tommasogualtierotti/14keypad/README.md

# 14keypad
14 keys programmable Macropad, based on RP2040 MCU from Raspberry Pi, running [KMK](https://github.com/KMKfw/kmk_firmware) firmware

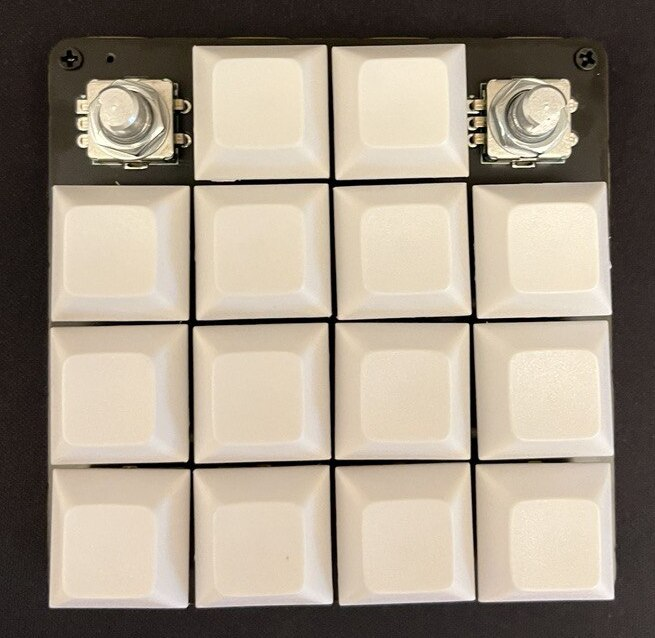
[picture p1: v1/assembled.jpg]
