tommasogualtierotti/14keypad/v1/back.png

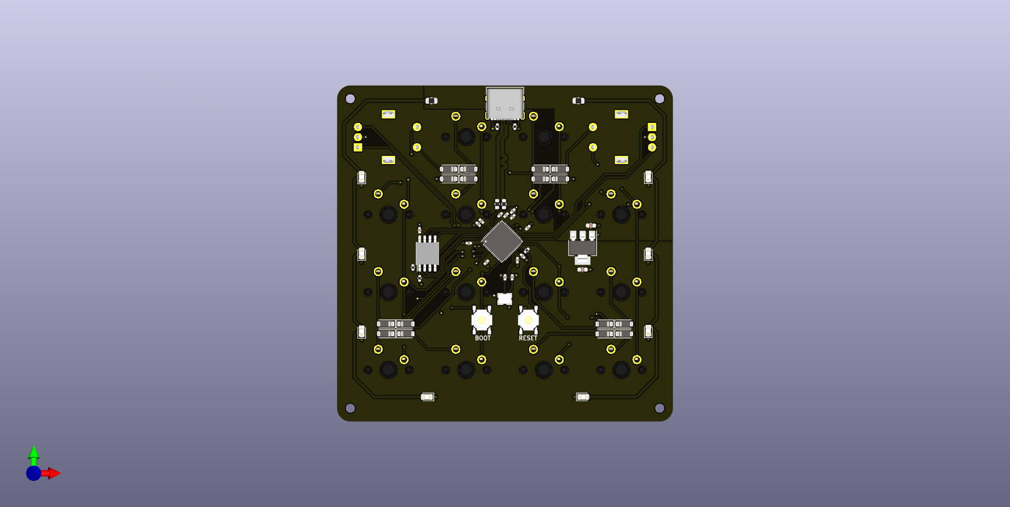
v1/back.png
