tommasogualtierotti/14keypad/v1/14keypad.kicad_pcb

## KiCad design v1/14keypad.kicad_pcb (2023-10-14)

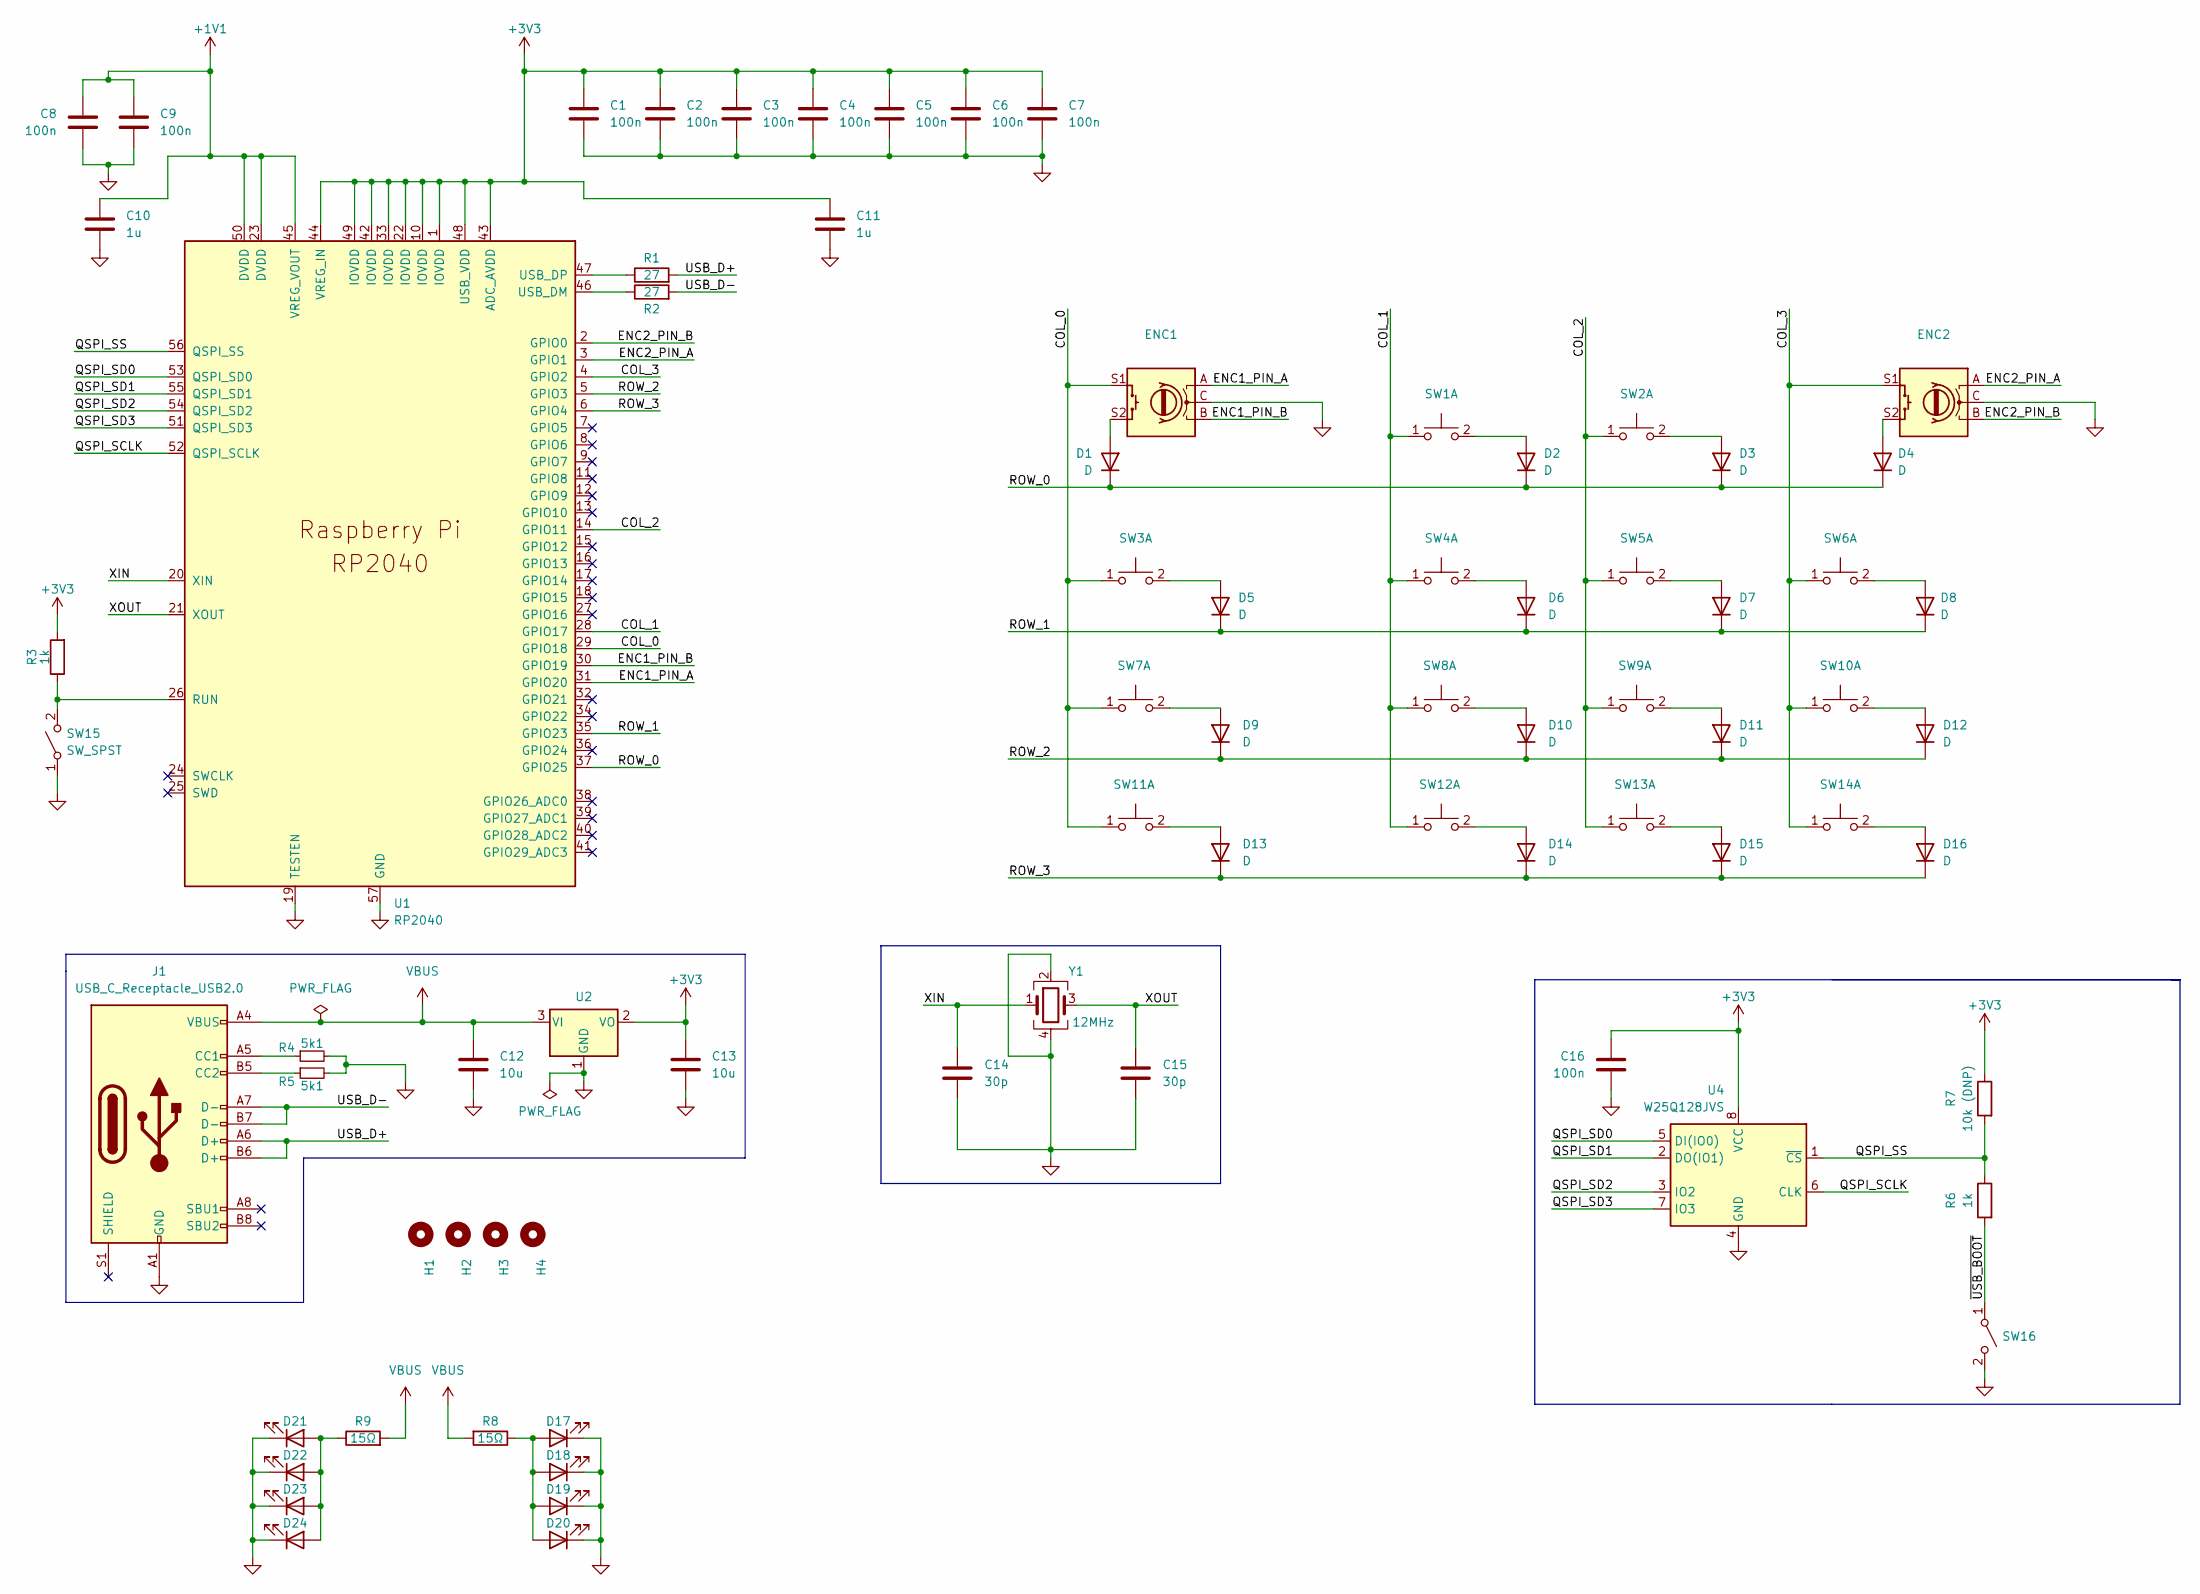
[picture p3: schematic 14keypad.kicad_sch]

Parts:
C1, C2, C3, C4, C5, C6, C7, C8, C9, C16: 100n; C_0402_1005Metric
C10, C11: 1u; C_0402_1005Metric
C12, C13: 10u; C_0603_1608Metric
C14, C15: 30p; C_0402_1005Metric
D1, D2, D3, D4, D5, D6, D7, D8, D9, D10, D11, D12, D13, D14, D15, D16: D; D_SOD-123
D17, D18, D19, D20, D21, D22, D23, D24: LED; D_0805_2012Metric
ENC1, ENC2: Encoder_Switch; RotaryEncoder_Alps_EC11E-Switch_Vertical_H20mm
H1, H2, H3, H4: MountingHole; MountingHole_2.2mm_M2
J1: USB_C_Receptacle_USB2.0; USB_C_Receptacle_XKB_U262-16XN-4BVC11
R1, R2: 27; R_0603_1608Metric
R3, R6: 1k; R_0402_1005Metric
R4, R5: 5k1; R_0402_1005Metric
R7: 10k (DNP); R_0402_1005Metric
R8: 15Ω; R_0805_2012Metric
R9: 15Ω; R_0805_2012Metric; JLCPCB_PART_NUMBER C17480
SW1, SW2, SW3, SW4, SW5, SW6, SW7, SW8, SW9, SW10, SW11, SW12, SW13, SW14: KEY_MX; SW_Cherry_MX_1.00u_PCB_UPDATED_FOOTPRINT_RIGHT_PIN_ASSIGNME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
SW15, SW16: SW_SPST; SW_Push_1P1T_XKB_TS-1187A
U1: RP2040; RP2040-QFN-56; JLCPCB_PART_NUMBER C2040
U2: NCP1117-3.3_SOT223; SOT-223-3_TabPin2
U4: W25Q128JVS; SOIC-8_5.23x5.23mm_P1.27mm
Y1: 12MHz; Crystal_SMD_3225-4Pin_3.2x2.5mm

Connections:
+1V1: C8.2, C9.1, C10.1, U1.23 (DVDD), U1.45 (VREG_VOUT), U1.50 (DVDD)
+3V3: C1.1, C2.1, C3.1, C4.1, C5.1, C6.1, C7.1, C11.1, C13.1, C16.1, R3.2, R7.1, U1.1 (IOVDD), U1.10 (IOVDD), U1.22 (IOVDD), U1.33 (IOVDD), U1.42 (IOVDD), U1.43 (ADC_AVDD), U1.44 (VREG_IN), U1.48 (USB_VDD), U1.49 (IOVDD), U2.2 (VO), U4.8 (VCC)
/COL_0: ENC1.S1, SW3.1, SW7.1, SW11.1, U1.29 (GPIO18)
/COL_1: SW1.1, SW4.1, SW8.1, SW12.1, U1.28 (GPIO17)
/COL_2: SW2.1, SW5.1, SW9.1, SW13.1, U1.14 (GPIO11)
/COL_3: ENC2.S1, SW6.1, SW10.1, SW14.1, U1.4 (GPIO2)
/ENC1_PIN_A: ENC1.A, U1.31 (GPIO20)
/ENC1_PIN_B: ENC1.B, U1.30 (GPIO19)
/ENC2_PIN_A: ENC2.A, U1.3 (GPIO1)
/ENC2_PIN_B: ENC2.B, U1.2 (GPIO0)
/QSPI_SCLK: U1.52 (QSPI_SCLK), U4.6 (CLK)
/QSPI_SD0: U1.53 (QSPI_SD0), U4.5 (DI(IO0))
/QSPI_SD1: U1.55 (QSPI_SD1), U4.2 (DO(IO1))
/QSPI_SD2: U1.54 (QSPI_SD2), U4.3 (IO2)
/QSPI_SD3: U1.51 (QSPI_SD3), U4.7 (IO3)
/QSPI_SS: R6.1, R7.2, U1.56 (QSPI_SS), U4.1 (~CS)
/ROW_0: D1.1 (K), D2.1 (K), D3.1 (K), D4.1 (K), U1.37 (GPIO25)
/ROW_1: D5.1 (K), D6.1 (K), D7.1 (K), D8.1 (K), U1.35 (GPIO23)
/ROW_2: D9.1 (K), D10.1 (K), D11.1 (K), D12.1 (K), U1.5 (GPIO3)
/ROW_3: D13.1 (K), D14.1 (K), D15.1 (K), D16.1 (K), U1.6 (GPIO4)
/USB_D+: J1.A6 (D+), J1.B6 (D+), R1.2
/USB_D-: J1.A7 (D-), J1.B7 (D-), R2.2
/XIN: C14.1, U1.20 (XIN), Y1.1
/XOUT: C15.1, U1.21 (XOUT), Y1.3
/~USB_BOOT: R6.2, SW16.1 (A)
GND: C1.2, C2.2, C3.2, C4.2, C5.2, C6.2, C7.2, C8.1, C9.2, C10.2, C11.2, C12.2, C13.2, C14.2, C15.2, C16.2, D17.1 (K), D18.1 (K), D19.1 (K), D20.1 (K), D21.1 (K), D22.1 (K), D23.1 (K), D24.1 (K), ENC1.C, ENC2.C, J1.A1 (GND), J1.A12 (GND), J1.B1 (GND), J1.B12 (GND), R4.2, R5.2, SW15.1 (A), SW16.2 (B), U1.19 (TESTEN), U1.57 (GND), U2.1 (GND), U4.4 (GND), Y1.2, Y1.4
unnamed: D1.2 (A), ENC1.S2
unnamed: D2.2 (A), SW1.2
unnamed: D3.2 (A), SW2.2
unnamed: D4.2 (A), ENC2.S2
unnamed: D5.2 (A), SW3.2
unnamed: D6.2 (A), SW4.2
unnamed: D7.2 (A), SW5.2
unnamed: D8.2 (A), SW6.2
unnamed: D9.2 (A), SW7.2
unnamed: D10.2 (A), SW8.2
unnamed: D11.2 (A), SW9.2
unnamed: D12.2 (A), SW10.2
unnamed: D13.2 (A), SW11.2
unnamed: D14.2 (A), SW12.2
unnamed: D15.2 (A), SW13.2
unnamed: D16.2 (A), SW14.2
unnamed: D17.2 (A), D18.2 (A), D19.2 (A), D20.2 (A), R8.1
unnamed: D21.2 (A), D22.2 (A), D23.2 (A), D24.2 (A), R9.1
unnamed: J1.A5 (CC1), R4.1
unnamed: J1.B5 (CC2), R5.1
unnamed: R3.1, SW15.2 (B), U1.26 (RUN)
unnamed: R2.1, U1.46 (USB_DM)
unnamed: R1.1, U1.47 (USB_DP)
VBUS: C12.1, J1.A4 (VBUS), J1.A9 (VBUS), J1.B4 (VBUS), J1.B9 (VBUS), R8.2, R9.2, U2.3 (VI)

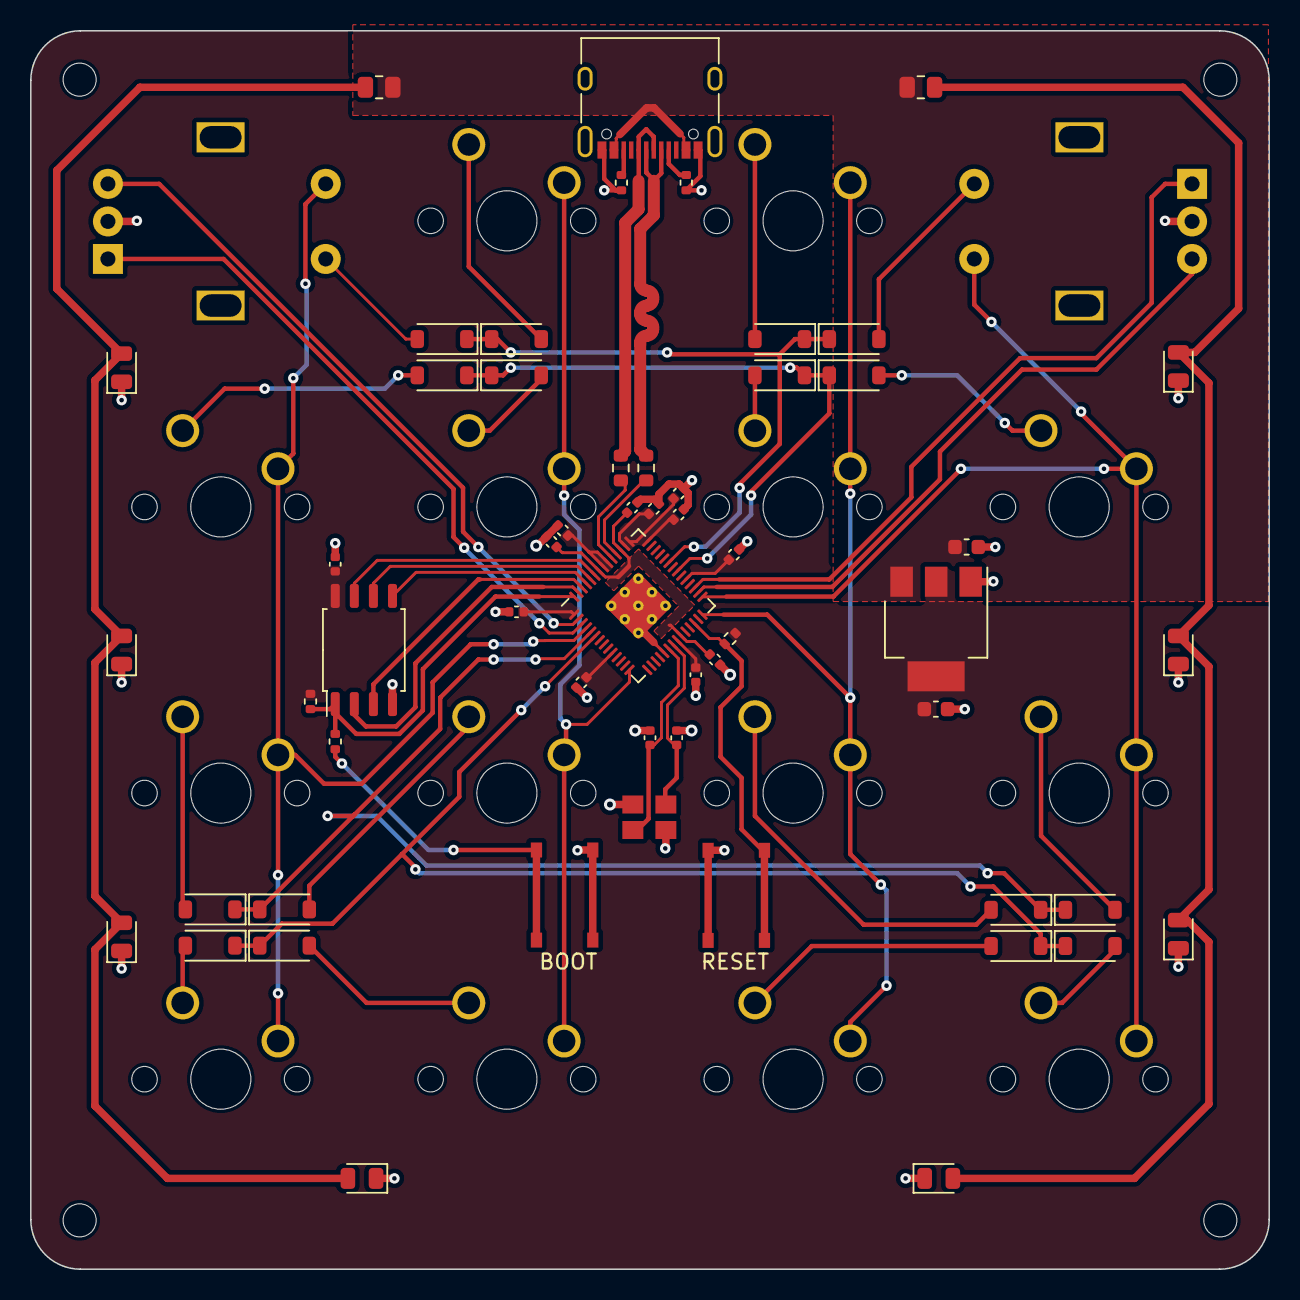
[picture p4: board 14keypad.kicad_pcb from above]

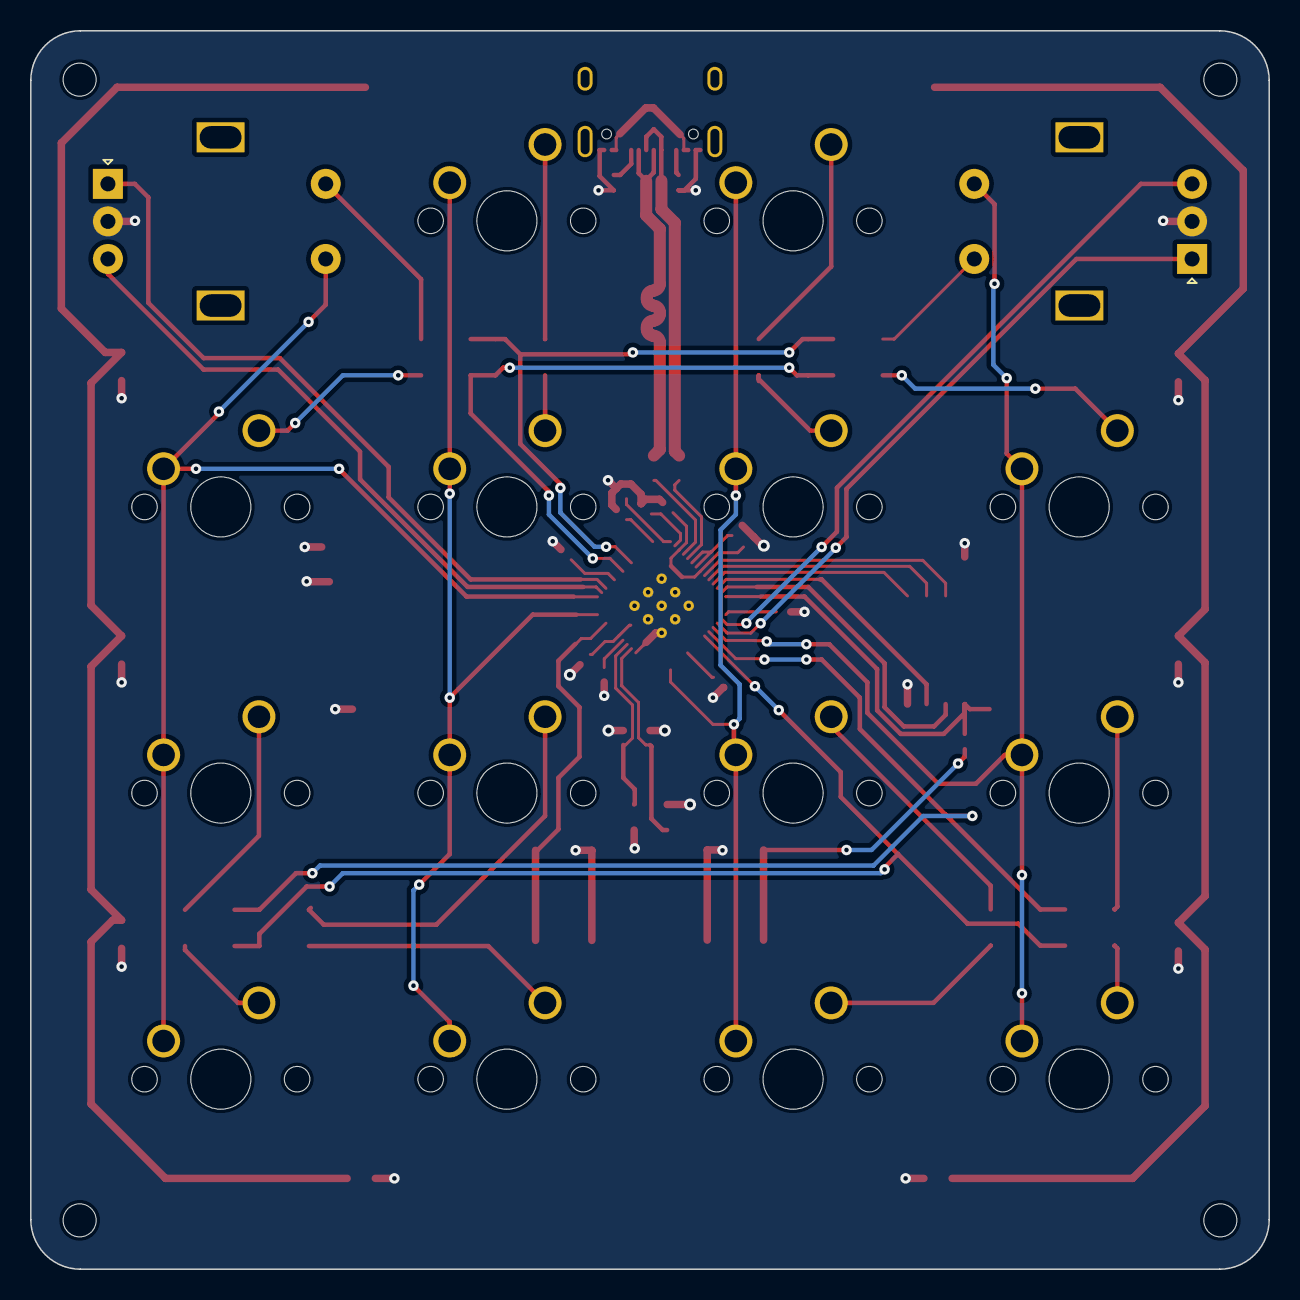
[picture p5: board 14keypad.kicad_pcb from below]

Board: 2 copper layers, 82.5 x 82.5 mm, 76 parts (16 on the bottom side), 50 nets.
