tommasogualtierotti/14keypad/(commit log)

2023-10-14 general commit
    [14keypad.kicad_pcb, 14keypad.kicad_sch]
2023-10-14 add assembled macropad photo
2023-10-15 add assembled photo
2025-06-05 add gerbers file for manufacturing
    [BOM.csv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]
